TobiO-Netizen/BajaSAE_UnionTelemetry/hardware/images/VehicularAkashaFINAL.jpg

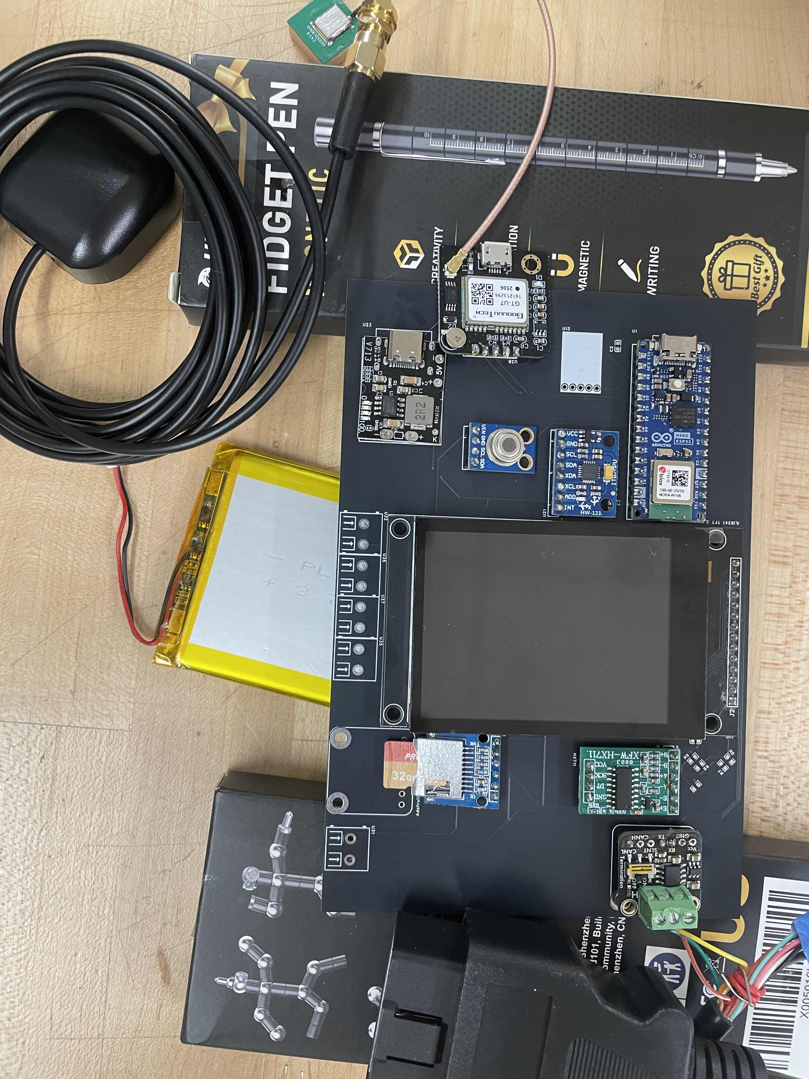
hardware/images/VehicularAkashaFINAL.jpg
