TobiO-Netizen/BajaSAE_UnionTelemetry/hardware/images/OBDII_PORT_LOCATIONS.png

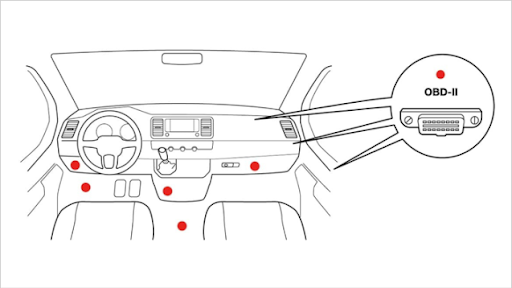
hardware/images/OBDII_PORT_LOCATIONS.png
