TobiO-Netizen/BajaSAE_UnionTelemetry/hardware/images/OBDII_SerialOutput.png

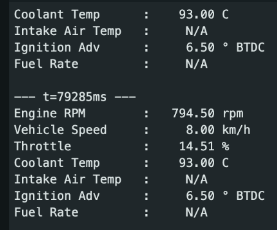
hardware/images/OBDII_SerialOutput.png
