TobiO-Netizen/BajaSAE_UnionTelemetry/hardware/images/PCB_Layout.jpg

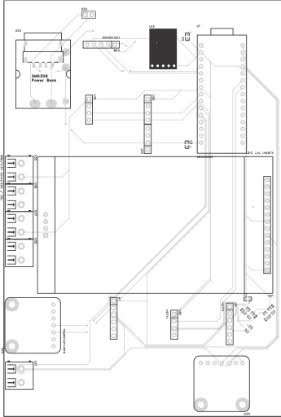
hardware/images/PCB_Layout.jpg
