TobiO-Netizen/BajaSAE_UnionTelemetry/hardware/images/Schematics.png

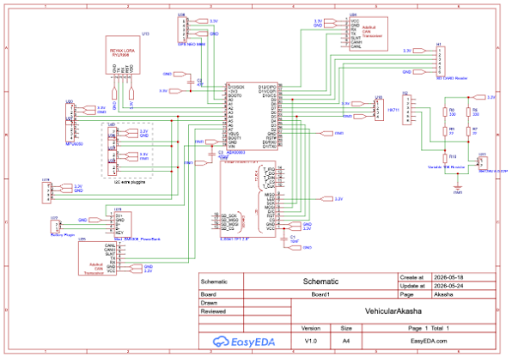
hardware/images/Schematics.png
