TobiO-Netizen/BajaSAE_UnionTelemetry/firmware/CarTelemetry/CarTelemetry.ino

#include <lvgl.h>
#include <TFT_eSPI.h>
#include "ui.h"
#include "MainSystem.h"

MainSystem sys;

static const uint16_t screenWidth  = 320;
static const uint16_t screenHeight = 240;

static lv_disp_draw_buf_t draw_buf;
static lv_color_t buf[ screenWidth * screenHeight / 10 ];

TFT_eSPI tft = TFT_eSPI(screenWidth, screenHeight);

void my_disp_flush( lv_disp_drv_t *disp, const lv_area_t *area, lv_color_t *color_p )
{
    uint32_t w = ( area->x2 - area->x1 + 1 );
    uint32_t h = ( area->y2 - area->y1 + 1 );

    tft.startWrite();
    tft.setAddrWindow( area->x1, area->y1, w, h );
    tft.pushColors( ( uint16_t * )&color_p->full, w * h, true );
    tft.endWrite();

    lv_disp_flush_ready( disp );
}

void my_touchpad_read( lv_indev_drv_t * indev_driver, lv_indev_data_t * data )
{
    data->state = LV_INDEV_STATE_REL;
}

void setup()
{
    Serial.begin(115200);
    delay(1000);

    // Deselect both devices
    pinMode(5, OUTPUT);     // screen CS
    digitalWrite(5, HIGH);
    pinMode(17, OUTPUT);    // SD CS
    digitalWrite(17, HIGH);

    // Then screen
    lv_init();
    tft.begin();
    tft.setRotation(1);

    lv_disp_draw_buf_init(&draw_buf, buf, NULL, screenWidth * screenHeight / 10);

    static lv_disp_drv_t disp_drv;
    lv_disp_drv_init(&disp_drv);
    disp_drv.hor_res = screenWidth;
    disp_drv.ver_res = screenHeight;
    disp_drv.flush_cb = my_disp_flush;
    disp_drv.draw_buf = &draw_buf;
    lv_disp_drv_register(&disp_drv);

    static lv_indev_drv_t indev_drv;
    lv_indev_drv_init(&indev_drv);
    indev_drv.type = LV_INDEV_TYPE_POINTER;
    indev_drv.read_cb = my_touchpad_read;
    lv_indev_drv_register(&indev_drv);

    ui_init();
    sys.begin();    // SD already mounted, begin() will skip it
}

void loop()
{
    lv_timer_handler();
    sys.update();
    delay(5);
}
